icl-rocketry/Ricardo-CANRepeater/CAN_RepIso/3D/CANRepIso.step

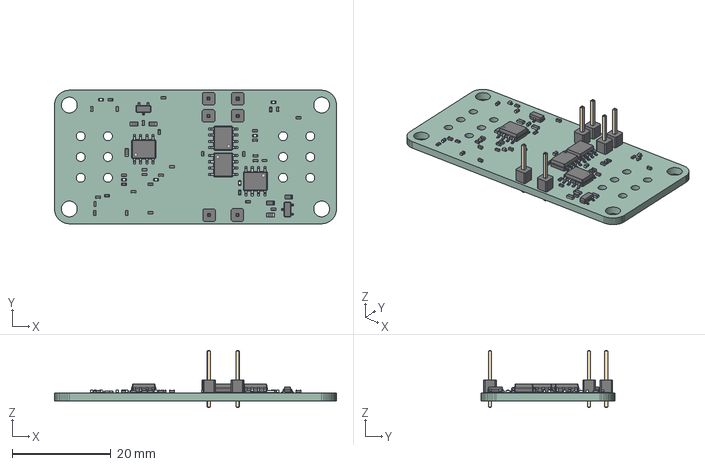
[picture p1: CAD file, 2023-04-14]
CAN_RepIso/3D/CANRepIso.step
57.0 x 27.0 x 11.5 mm
PCB
