icl-rocketry/Ricardo-CANRepeater/CAN_RepIso/CANRepIso.kicad_pcb

## KiCad design CAN_RepIso/CANRepIso.kicad_pcb (2024-09-12)

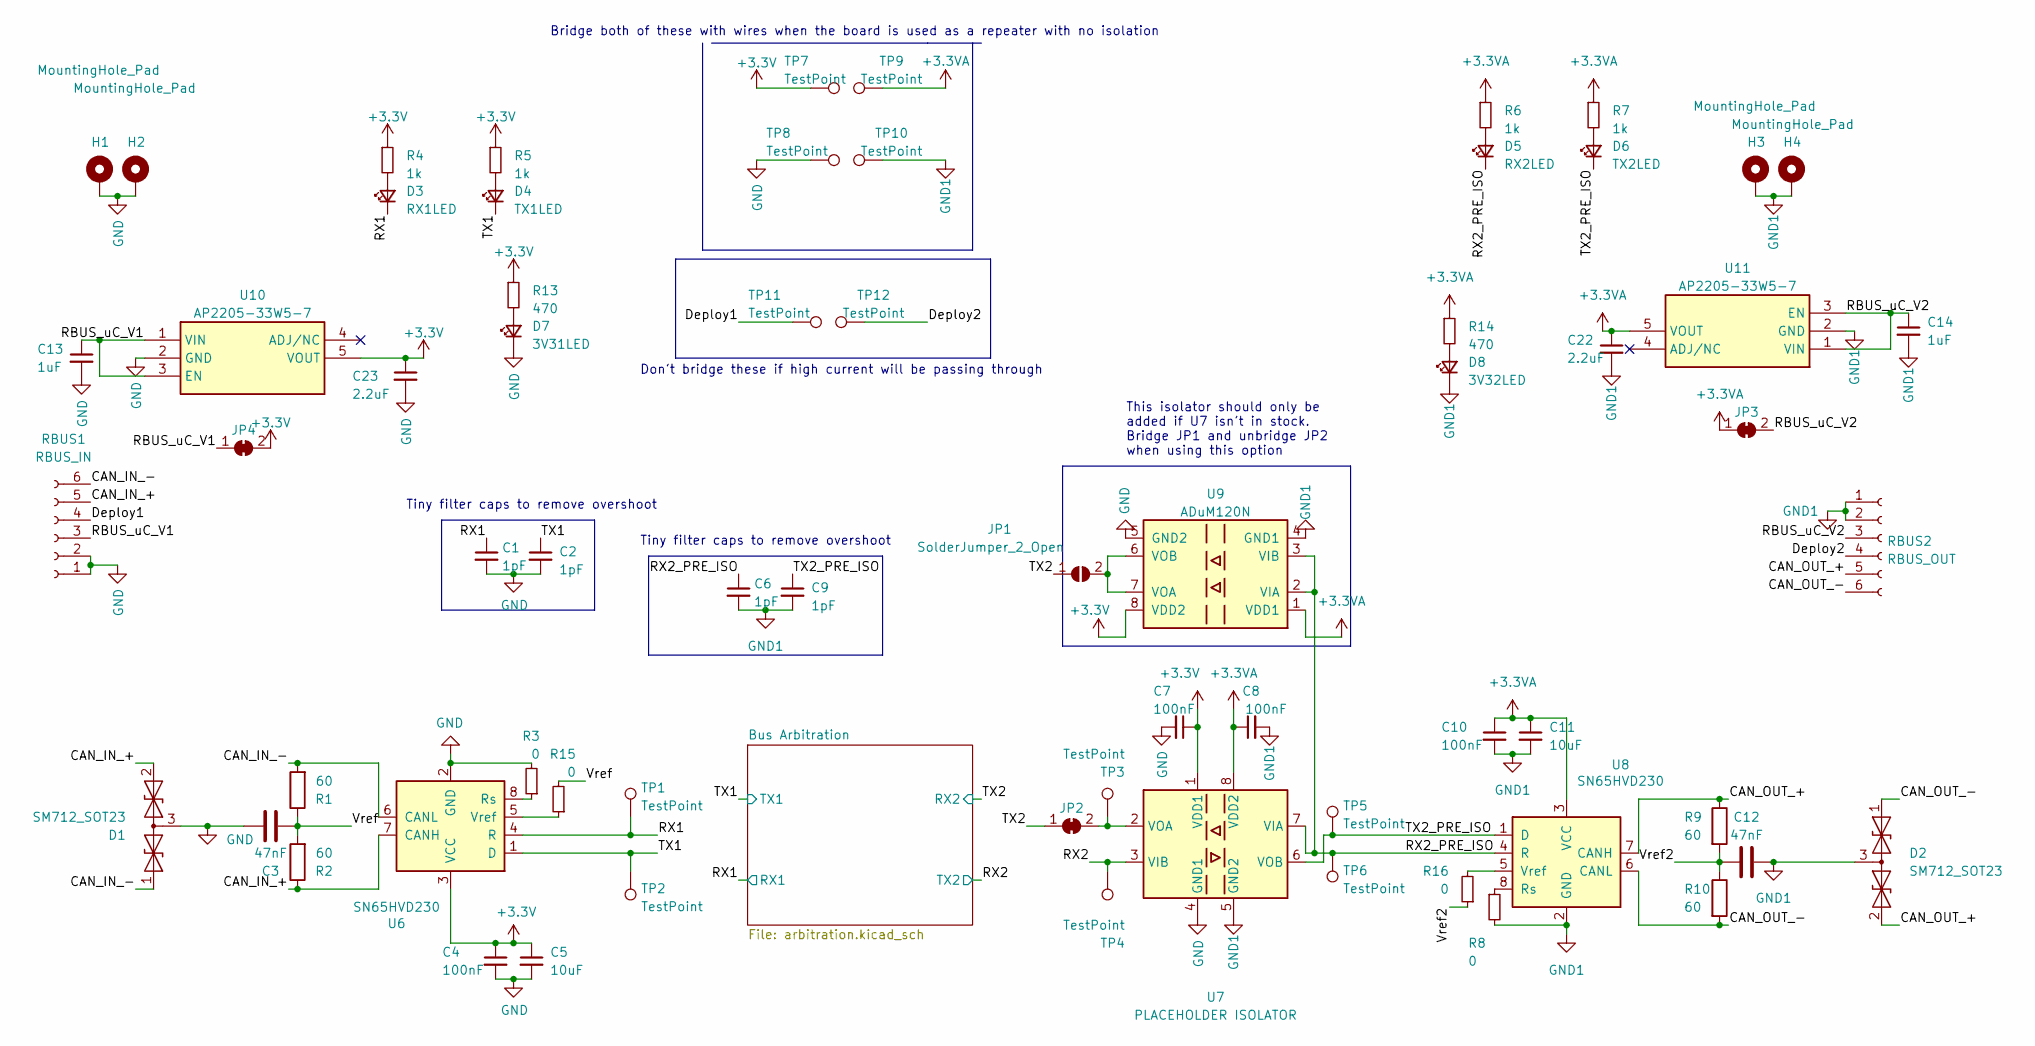
[picture p2: schematic CANRepIso.kicad_sch, CAN Repeater and Isolator]

Parts:
C1, C2, C6, C9: 1pF; C_0402_1005Metric
C3, C12: 47nF; C_0402_1005Metric
C4, C7, C8, C10: 100nF; C_0402_1005Metric
C5, C11: 10uF; C_0402_1005Metric
C13, C14: 1uF; C_0402_1005Metric
C22, C23: 2.2uF; C_0402_1005Metric
D1, D2: SM712_SOT23; SOT-23
D3: RX1LED; LED_0402_1005Metric
D4: TX1LED; LED_0402_1005Metric
D5: RX2LED; LED_0402_1005Metric
D6: TX2LED; LED_0402_1005Metric
D7: 3V31LED; LED_0402_1005Metric
D8: 3V32LED; LED_0402_1005Metric
H1, H2, H3, H4: MountingHole_Pad; MountingHole_3.2mm_M3_DIN965_Pad
JP1: SolderJumper_2_Open; SolderJumper-2_P1.3mm_Open_RoundedPad1.0x1.5mm
JP2, JP3, JP4: SolderJumper_2_Bridged; SolderJumper-2_P1.3mm_Bridged_RoundedPad1.0x1.5mm
R1, R2, R9, R10: 60; R_0603_1608Metric
R3, R8: 0; R_0603_1608Metric
R4, R5, R6, R7: 1k; R_0402_1005Metric
R13, R14: 470; R_0402_1005Metric
R15, R16: 0; R_0402_1005Metric
RBUS1: RBUS_IN; Molex_Mini-Fit_Jr_5569-06A2_2x03_P4.20mm_Horizontal
RBUS2: RBUS_OUT; Molex_Mini-Fit_Jr_5569-06A2_2x03_P4.20mm_Horizontal
TP1, TP2, TP3, TP4, TP5, TP6: TestPoint; TestPoint_Pad_D1.0mm
TP7, TP8, TP9, TP10, TP11, TP12: TestPoint; PinHeader_1x01_P2.54mm_Vertical
U6, U8: SN65HVD230; SOIC-8_3.9x4.9mm_P1.27mm
U7: PLACEHOLDER ISOLATOR; SOIC-8_3.9x4.9mm_P1.27mm
U9: ADuM120N; SOIC-8_3.9x4.9mm_P1.27mm
U10, U11: AP2205-33W5-7; SOT95P282X145-5N; Mouser Part Number 621-AP2205-W5-7

Connections:
+3.3VA: C8.1, C10.1, C11.1, C22.1, JP3.1 (A), R6.1, R7.1, R14.1, TP9.1, U7.8 (VDD2), U8.3 (VCC), U9.1 (VDD1), U11.5 (VOUT)
+3V3: C4.1, C5.1, C7.1, C23.1, JP4.2 (B), R4.1, R5.1, R13.1, TP7.1, U6.3 (VCC), U7.1 (VDD1), U9.8 (VDD2), U10.5 (VOUT); also elsewhere on the board
/CAN_IN_+: D1.2 (A2), R2.1, RBUS1.5, U6.7 (CANH)
/CAN_IN_-: D1.1 (A1), R1.2, RBUS1.6, U6.6 (CANL)
/CAN_OUT_+: D2.2 (A2), R9.1, RBUS2.5, U8.7 (CANH)
/CAN_OUT_-: D2.1 (A1), R10.2, RBUS2.6, U8.6 (CANL)
/Deploy1: RBUS1.4, TP11.1
/Deploy2: RBUS2.4, TP12.1
/RBUS_uC_V1: C13.1, JP4.1 (A), RBUS1.3, U10.1 (VIN), U10.3 (EN)
/RBUS_uC_V2: C14.1, JP3.2 (B), RBUS2.3, U11.1 (VIN), U11.3 (EN)
/RX1: C1.1, D3.1 (K), TP1.1, U6.4 (R); also elsewhere on the board
/RX2: TP4.1, U7.3 (VIB); also elsewhere on the board
/RX2_PRE_ISO: C6.1, D5.1 (K), TP6.1, U7.7 (VIA), U8.4 (R), U9.2 (VIA), U9.3 (VIB)
/TX1: C2.1, D4.1 (K), TP2.1, U6.1 (D); also elsewhere on the board
/TX2: JP1.1 (A), JP2.1 (A); also elsewhere on the board
/TX2_PRE_ISO: C9.1, D6.1 (K), TP5.1, U7.6 (VOB), U8.1 (D)
/Vref: C3.1, R1.1, R2.2, R15.2
/Vref2: C12.1, R9.2, R10.1, R16.1
GND: C1.2, C2.2, C3.2, C4.2, C5.2, C7.2, C13.2, C23.2, D1.3 (common), D7.1 (K), H1.1, H2.1, R3.2, RBUS1.1, RBUS1.2, TP8.1, U6.2 (GND), U7.4 (GND1), U9.5 (GND2), U10.2 (GND); also elsewhere on the board
GND1: C6.2, C8.2, C9.2, C10.2, C11.2, C12.2, C14.2, C22.2, D2.3 (common), D8.1 (K), H3.1, H4.1, R8.2, RBUS2.1, RBUS2.2, TP10.1, U7.5 (GND2), U8.2 (GND), U9.4 (GND1), U11.2 (GND)
unnamed: D3.2 (A), R4.2
unnamed: D4.2 (A), R5.2
unnamed: D5.2 (A), R6.2
unnamed: D6.2 (A), R7.2
unnamed: D7.2 (A), R13.2
unnamed: D8.2 (A), R14.2
unnamed: JP1.2 (B), U9.6 (VOB), U9.7 (VOA)
unnamed: JP2.2 (B), TP3.1, U7.2 (VOA)
unnamed: R3.1, U6.8 (Rs)
unnamed: R15.1, U6.5 (Vref)
unnamed: R8.1, U8.8 (Rs)
unnamed: R16.2, U8.5 (Vref)

Notes on the sheet:
Tiny filter caps to remove overshoot
This isolator should only be added if U7 isn't in stock. Bridge JP1 and unbridge JP2 when using this option
Don't bridge these if high current will be passing through
Bridge both of these with wires when the board is used as a repeater with no isolation

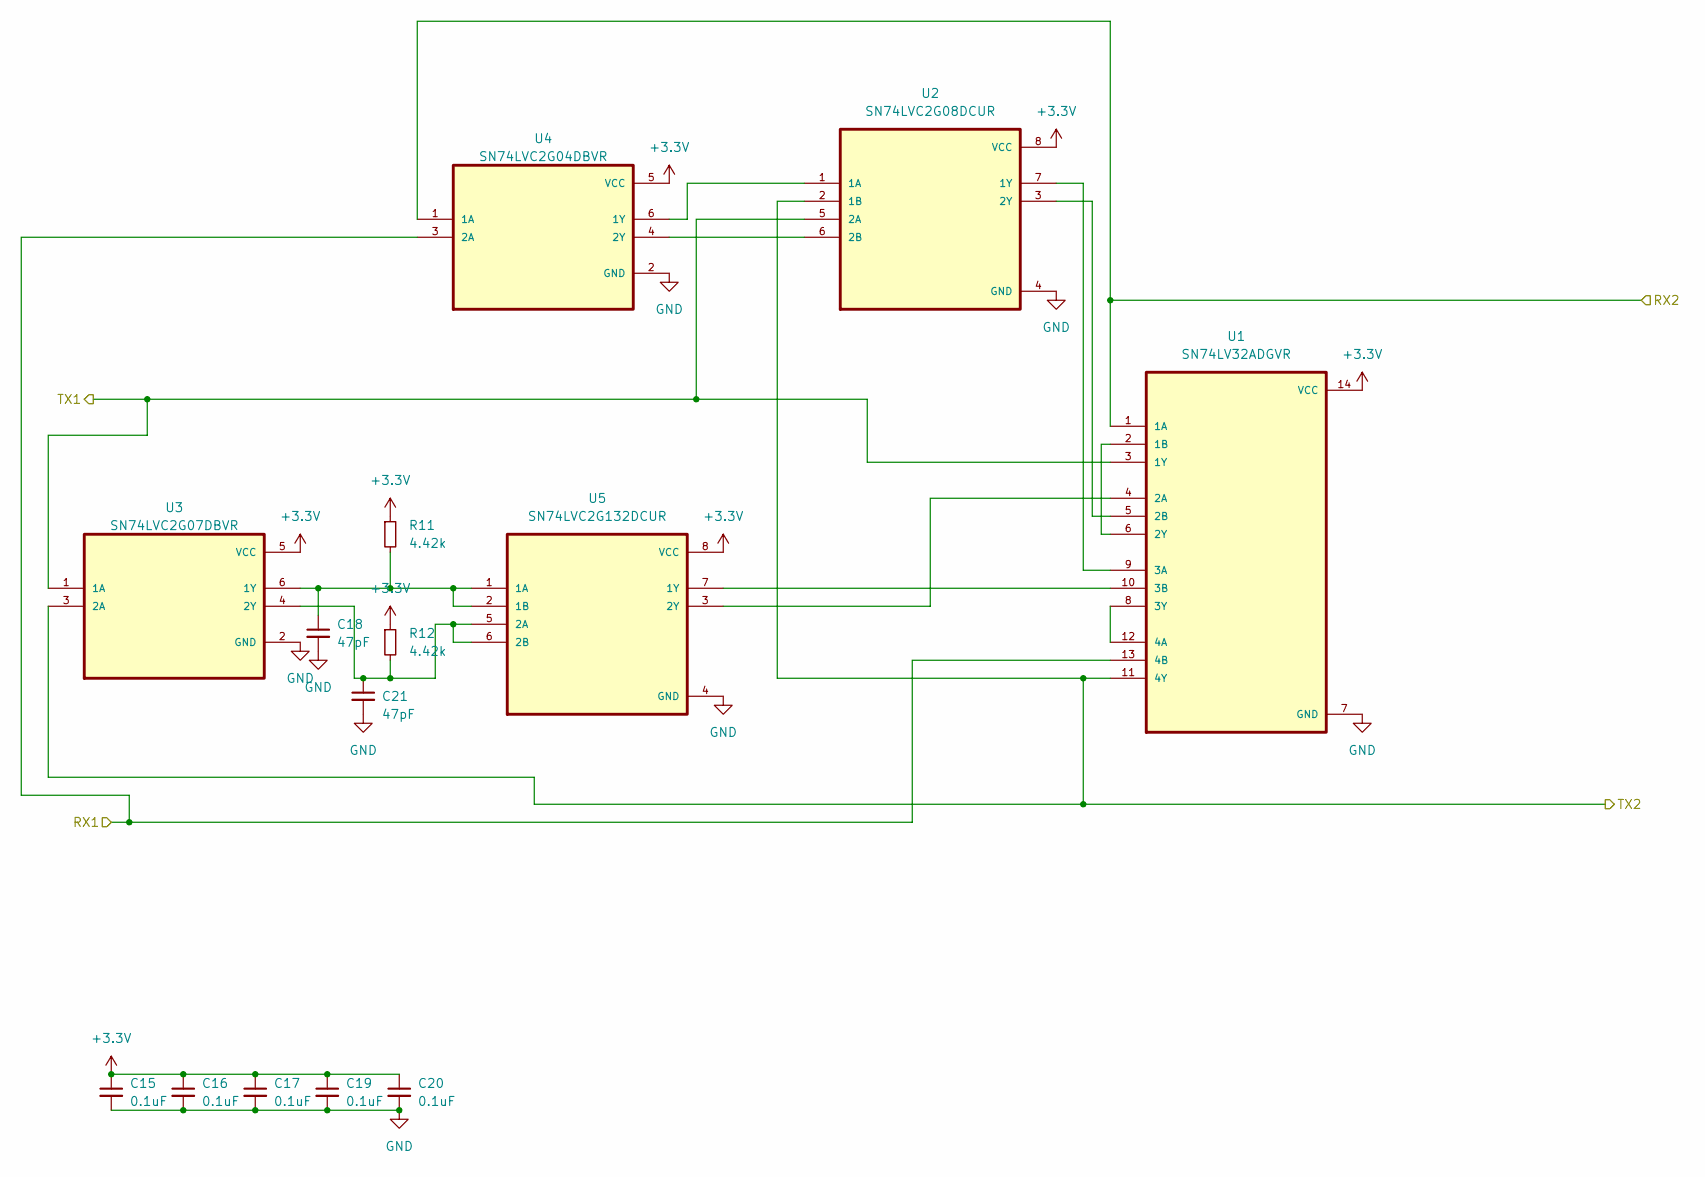
[picture p3: schematic arbitration.kicad_sch]

Parts:
C15, C16, C17, C19, C20: 0.1uF; C_0402_1005Metric
C18, C21: 47pF; C_0402_1005Metric
R11, R12: 4.42k; R_0402_1005Metric
U1: SN74LV32ADGVR; SOP40P640X120-14N
U2: SN74LVC2G08DCUR; SOP50P310X90-8N
U3: SN74LVC2G07DBVR; SOT95P280X145-6N
U4: SN74LVC2G04DBVR; SOT95P280X145-6N
U5: SN74LVC2G132DCUR; SOP50P310X90-8N

Connections:
+3V3: C15.1, C16.1, C17.1, C19.1, C20.1, R11.1, R12.1, U1.14 (VCC), U2.8 (VCC), U3.5 (VCC), U4.5 (VCC), U5.8 (VCC); also elsewhere on the board
/RX1: U1.13 (4B), U4.3 (2A); also elsewhere on the board
/RX2: U1.11 (4Y), U2.2 (1B), U3.3 (2A); also elsewhere on the board
/TX1: U1.3 (1Y), U2.5 (2A), U3.1 (1A); also elsewhere on the board
/TX2: U1.1 (1A), U4.1 (1A); also elsewhere on the board
GND: C15.2, C16.2, C17.2, C18.2, C19.2, C20.2, C21.2, U1.7 (GND), U2.4 (GND), U3.2 (GND), U4.2 (GND), U5.4 (GND); also elsewhere on the board
unnamed: U1.2 (1B), U1.6 (2Y)
unnamed: U1.4 (2A), U5.3 (2Y)
unnamed: U1.5 (2B), U2.3 (2Y)
unnamed: U1.9 (3A), U2.7 (1Y)
unnamed: U1.10 (3B), U5.7 (1Y)
unnamed: U1.8 (3Y), U1.12 (4A)
unnamed: U2.1 (1A), U4.6 (1Y)
unnamed: U2.6 (2B), U4.4 (2Y)
unnamed: C18.1, R11.2, U3.6 (1Y), U5.1 (1A), U5.2 (1B)
unnamed: C21.1, R12.2, U3.4 (2Y), U5.5 (2A), U5.6 (2B)

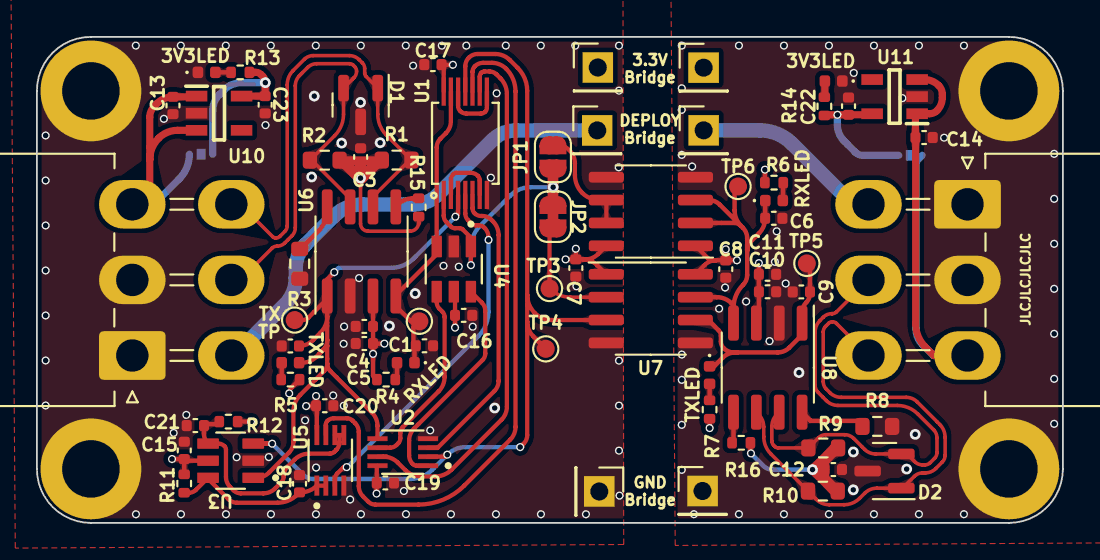
[picture p4: board CANRepIso.kicad_pcb from above]

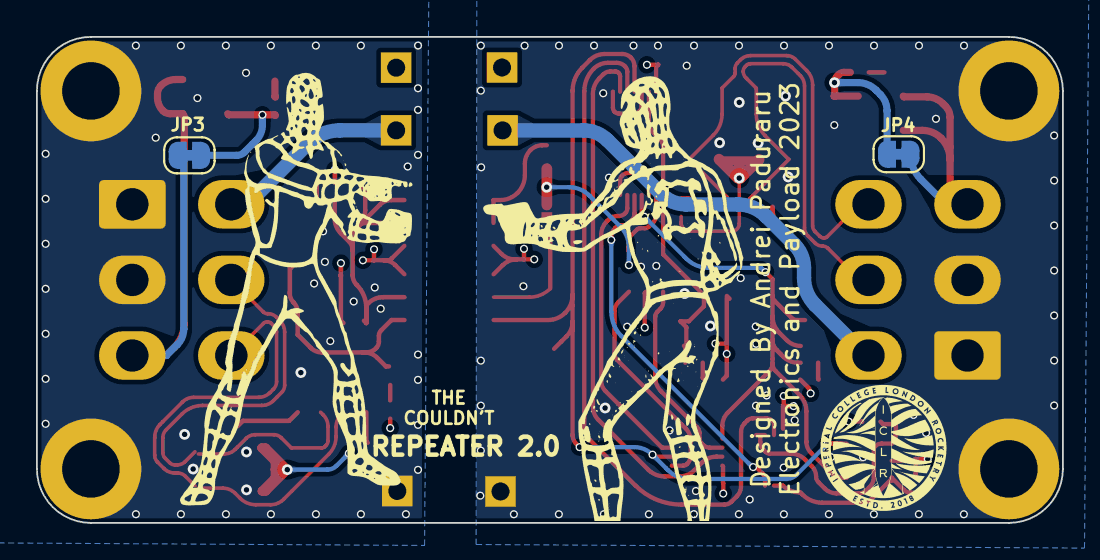
[picture p5: board CANRepIso.kicad_pcb from below]

Board: 4 copper layers, 57.0 x 27.0 mm, 80 parts (2 on the bottom side), 42 nets.
