icl-rocketry/Ricardo-CANRepeater/(commit log)

2021-12-04 Revert "Jiawei yao 2022 patch 1"
    [AMCA31-2R450G-S1F-T3.step, IMU.sch, Mainboard.kicad_pcb, Mainboard.sch, Nukes.sch, Ricardo_Nov_7_larger_usb_c.sch, analogue.sch, analogueI2C.sch]
2022-04-01 Added finished schematic for CAN repeater & isolator
    [CANRepIso.kicad_pcb, CANRepIso.kicad_sch, arbitration.kicad_sch]
2022-04-04 Layout done
    still needs touchups on the planes and the rounded corner
    [CANRepIso.kicad_pcb, CANRepIso.kicad_sch, arbitration.kicad_sch]
2022-04-04 Rounded corners + via stitching
    [CANRepIso.kicad_pcb]
2022-04-15 changed U4 from driver to NOT gate, implemented review feedback
    [CANRepIso.kicad_pcb, CANRepIso.kicad_sch, arbitration.kicad_sch]
2022-04-15 Added text and logos
    [CANRepIso.kicad_pcb, CANRepIso.kicad_sch]
2022-05-12 added option for a 2nd digital isolator
    [CANRepIso.kicad_pcb, CANRepIso.kicad_sch, arbitration.kicad_sch]
2023-02-18 fixed schematic, layout needs update
    [CANRepIso.kicad_sch, arbitration.kicad_sch]
2023-03-31 v2 finished pre-review
    [CANRepIso-B_Cu.gbl, CANRepIso-B_Mask.gbs, CANRepIso-B_Paste.gbp, CANRepIso-B_Silkscreen.gbo, CANRepIso-Edge_Cuts.gm1, CANRepIso-F_Cu.gtl, CANRepIso-F_Mask.gts, CANRepIso-F_Paste.gtp]
2023-03-31 moved literally 1 reference
    [CANRepIso.kicad_pcb]
2023-03-31 Fixed a stray via, removed holes from rbus connectors
    [CANRepIso-B_Cu.gbl, CANRepIso-B_Mask.gbs, CANRepIso-B_Paste.gbp, CANRepIso-B_Silkscreen.gbo, CANRepIso-Edge_Cuts.gm1, CANRepIso-F_Cu.gtl, CANRepIso-F_Mask.gts, CANRepIso-F_Paste.gtp]
2023-04-14 silkscreen tweaks
    [CANRepIso-B_Cu.gbl, CANRepIso-B_Mask.gbs, CANRepIso-B_Paste.gbp, CANRepIso-B_Silkscreen.gbo, CANRepIso-Edge_Cuts.gm1, CANRepIso-F_Cu.gtl, CANRepIso-F_Mask.gts, CANRepIso-F_Paste.gtp]
2023-06-29 some DRC
    [CANRepIso.kicad_pcb]
2023-07-12 oops forgot a connection
    [CANRepIso.kicad_pcb]
2023-07-12 some overlapping references oopsie
    [CANRepIso.kicad_pcb]
2024-09-12 Added 3d Components
    [CANRepIso.kicad_pcb]
